Grossstadtlegende/Hallbach_cylinder/CAD/HalbachCylinderRemakeV3.9 (9.95 magnet length, 15mm thick) w groove.STL

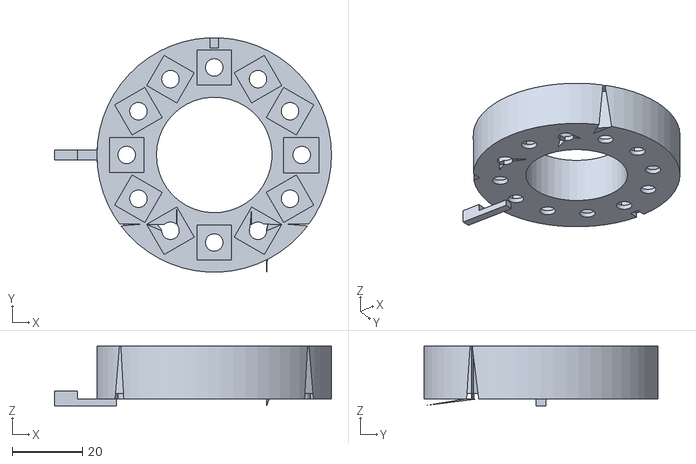
[picture p2: CAD file, 2020-01-30]
CAD/HalbachCylinderRemakeV3.9 (9.95 magnet length, 15mm thick) w groove.STL
79.1 x 67.0 x 17.0
