Grossstadtlegende/Hallbach_cylinder/CAD/Back cover.STL

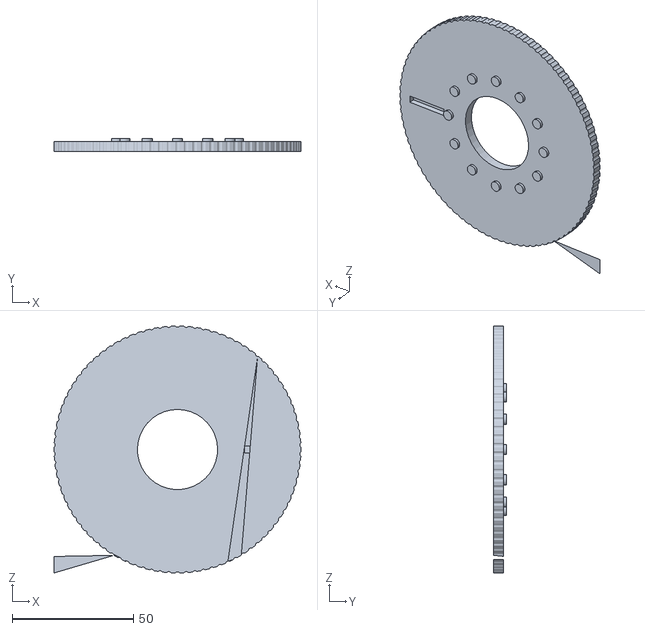
[picture p3: CAD file, 2020-01-30]
CAD/Back cover.STL
101.7 x 5.15 x 101.7
