Grossstadtlegende/Hallbach_cylinder/CAD/Outer ring w groove v2.STL

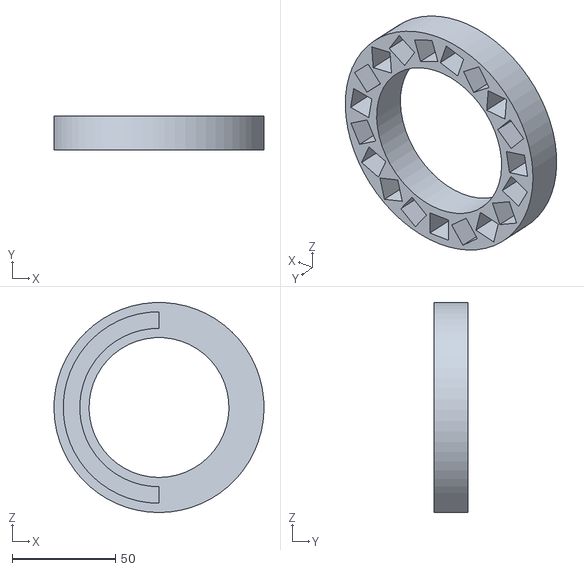
[picture p4: CAD file, 2020-01-30]
CAD/Outer ring w groove v2.STL
101.7 x 16.5 x 101.8
