Grossstadtlegende/Hallbach_cylinder/CAD/axial hall probe holder 32.25.SLDPRT

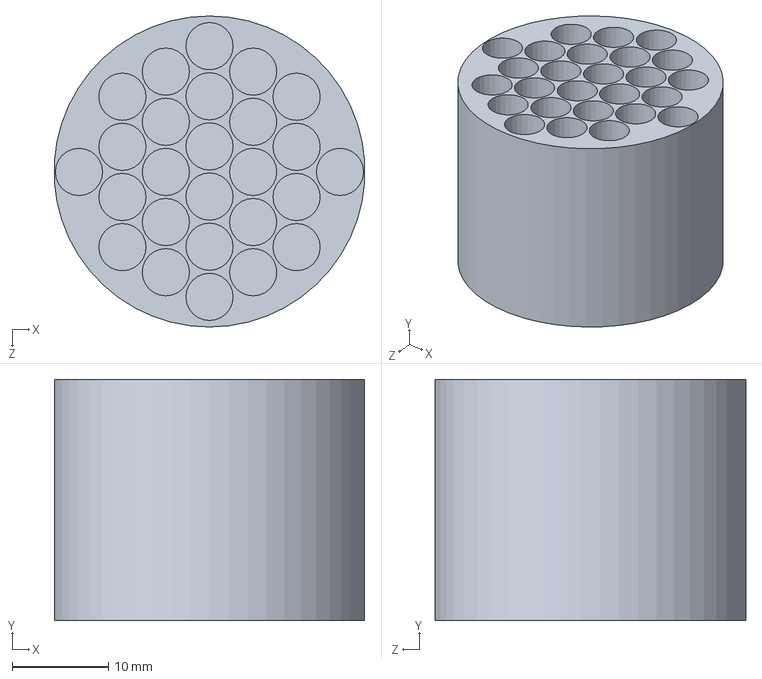
[picture p5: CAD file, 2019-03-29]
CAD/axial hall probe holder 32.25.SLDPRT
32.2 x 25.0 x 32.2 mm
