Grossstadtlegende/Hallbach_cylinder/CAD/HalbachCylinderRemakeV3.9 (9.95 magnet length, 15mm thick).STL

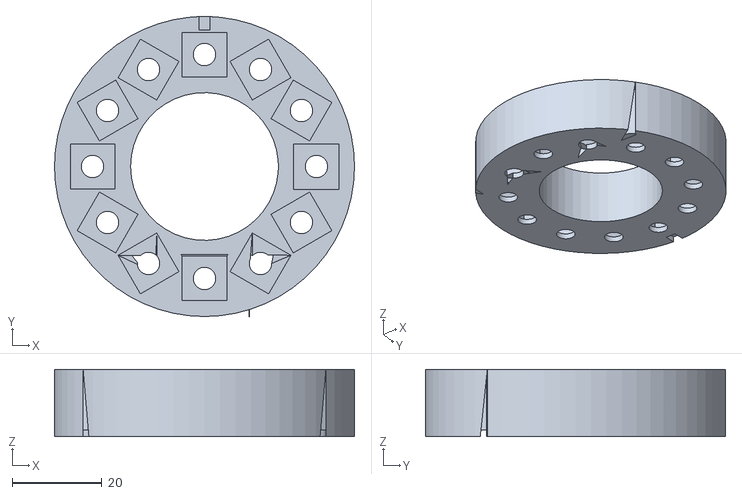
[picture p6: CAD file, 2019-03-29]
CAD/HalbachCylinderRemakeV3.9 (9.95 magnet length, 15mm thick).STL
67.0 x 67.0 x 15.0
