Grossstadtlegende/Hallbach_cylinder/CAD/V3.95 top half.STL

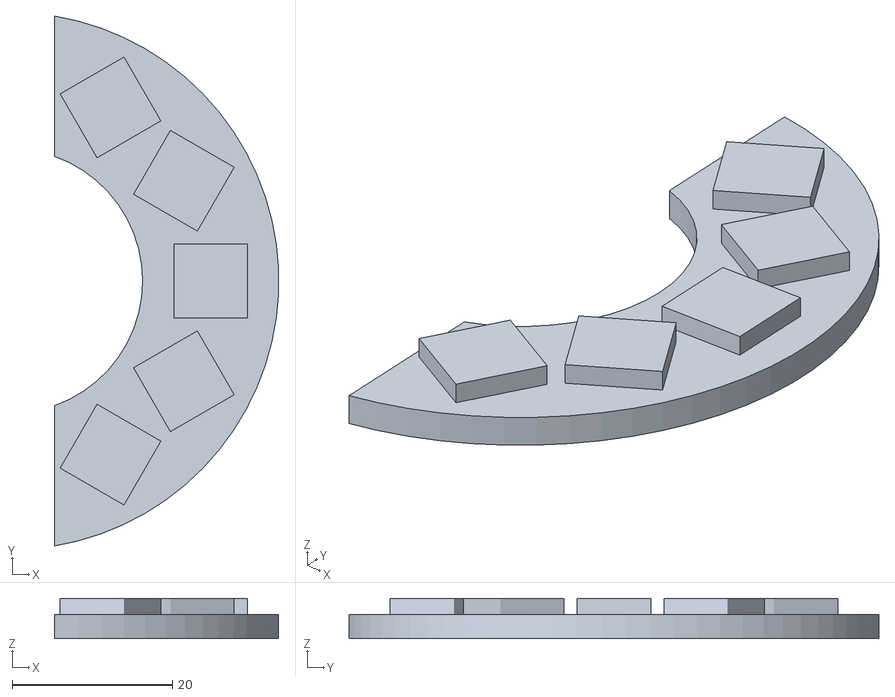
[picture p7: CAD file, 2019-03-29]
CAD/V3.95 top half.STL
28.0 x 66.1 x 5.00
