Grossstadtlegende/Hallbach_cylinder/CAD/V3.95 top half 2.STL

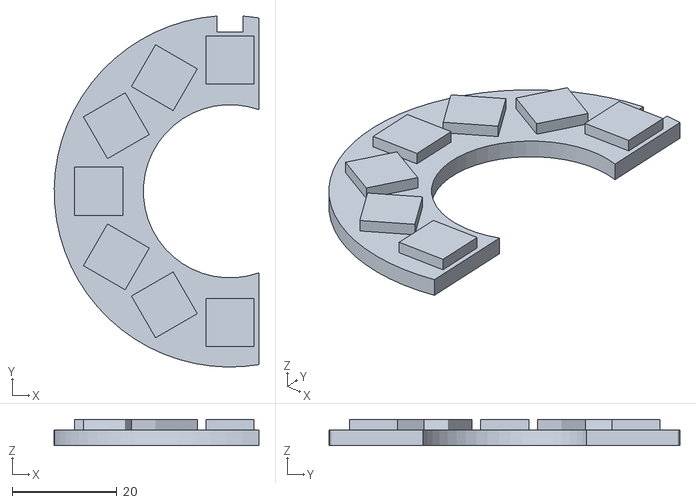
[picture p8: CAD file, 2019-03-29]
CAD/V3.95 top half 2.STL
39.0 x 66.9 x 5.00
