Grossstadtlegende/Hallbach_cylinder/CAD/HalbachTest0.STL

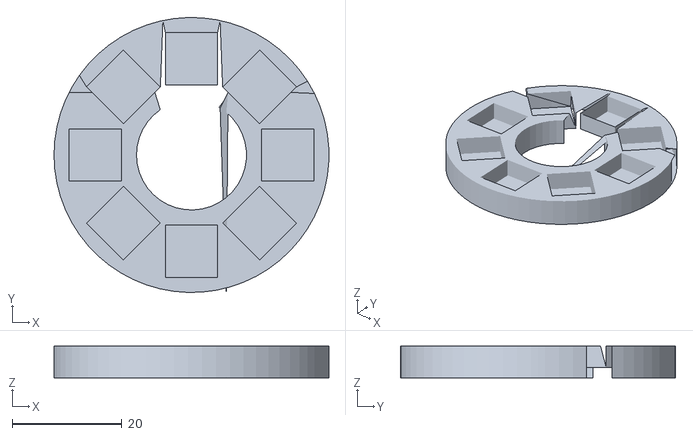
[picture p9: CAD file, 2019-02-19]
CAD/HalbachTest0.STL
50.0 x 50.0 x 5.76
