Grossstadtlegende/Hallbach_cylinder/CAD/Magnet.SLDPRT

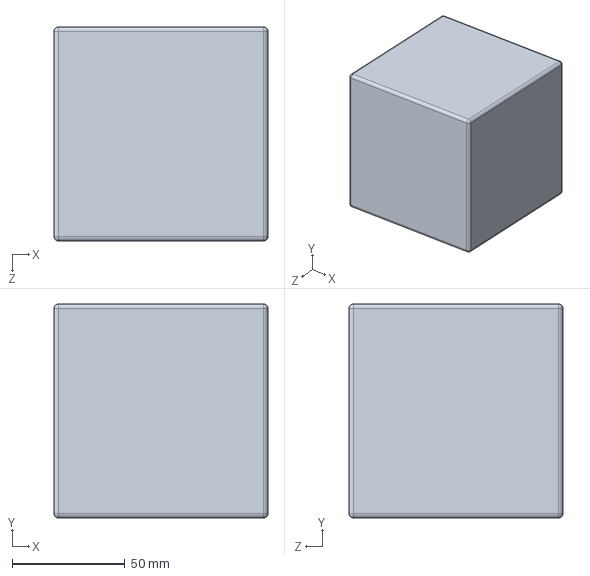
[picture p10: CAD file, 2019-01-28]
CAD/Magnet.SLDPRT
95.0 x 95.0 x 95.0 mm
