Grossstadtlegende/Hallbach_cylinder/(list of files, cad)

Other CAD files:
CAD/HalbachCylinder_V0.sldprt
