Grossstadtlegende/Hallbach_cylinder/Data/Individual Magnet testing.xlsx

Magnet 1 | (mT) |  |  | Average | Magnet 2
face 1 | 123.9 | 125.6 | 130.6 | 126.70 | 130.2 | 134.6 | 132.6 | 132.47
face 2 | -134.8 | -127.7 | -132.8 | -131.77 | -129.2 | -131.2 | -132.8 | -131.07
face 3 | 23.84 |  |  | 7.95 | Magnet 3
face 4 | -20.41 |  |  | -6.80 | 128 | 133.4 | 132.4 | 131.27
face 5 | -30.4 |  |  | -10.13 | -122.8 | -128.8 | -131.1 | -127.57
face 6 | -20.05 |  |  | -6.68 | Magnet 4
 |  |  |  | 0.00
where face 1 and 2 are along magnetic axis, and 4-6 should be comparatively weak |  |  |  | 0.00
Notes: |  |  |  | 0.00 | Magnet 5
*Began by zeroing transverse probe in the zero-field thingy |  |  |  | 0.00
Does appear to be slight differences in size, as fit of magnets varied in printed plate |  |  |  | 0.00
For clarification, measurements were taken with the unmarked side against the face |  |  |  | 0.00
White dots are considered as face 1 |  |  |  | 0.00
Tested magnets are in their own row in box |  |  |  | 0.00
 |  |  |  | 0.00
