Grossstadtlegende/Hallbach_cylinder/(commit log)

2019-01-25 added mikes original CAD
    [HalbachCylinder_V0.sldprt]
2019-01-25 Create Raich, Blümler - 2004 - Design and construction of a dipolar Halbach array with a homogeneous field from identical bar magnets NMR Mand.pdf
2019-01-28 Create Magnet.SLDPRT
    Created a CAD drawing for a cubic magnet
    [Magnet.SLDPRT]
2019-02-05 Equation Spreadsheet
    A spreadsheet containing both the equations given in Raich and Blumler as well as for calculating tangental and radial components of a magnetic field. Errors extremely plausible, but is being revised.
    [Magnet equations.xlsx]
2019-02-18 Halbach magnet positions
    A far simpler and more accurate spreadsheet with equations for the magnet positions
    [HalbachPositions (version 1).xlsx]
2019-02-19 HalbachTest0
    A .stl file for the first printed version of the Halbach cylinder
    [HalbachPositions (version 1).xlsx, HalbachTest0.STL]
2019-02-22 Updated AND color-coded for fun
    [HalbachPositions (version 1).xlsx, HalbachTest0.STL, Magnet equations.xlsx]
2019-03-04 Update HalbachPositions (version 1).xlsx
    [HalbachPositions (version 1).xlsx]
2019-03-29 Final (or near so) designs for the Hallbach cylinder
    [HalbachCylinderRemakeV3.9 (9.95 magnet length, 15mm thick).STL, HalbachPositions (version 1).xlsx, V3.95 top half 2.STL, V3.95 top half.STL, axial hall probe holder 32.25.SLDPRT]
2019-04-26 General updates of files
    [Back cover.STL, Halbach positions for outer ring.xlsx, HalbachCylinderRemakeV3.9 (9.95 magnet length, 15mm thick) w groove.STL, HalbachPositions (version 1).xlsx, Magnet equations.xlsx, Outer ring w groove v2.STL]
2019-07-05 Create Raich, Blümler - 2004 - Design and construction of a dipolar Halbach array with a homogeneous field from identical bar magnets NMR Mand.pdf
    add pdf
2020-01-28 Add new notes
    Added a document with a general overview of prototypes and project goals
2020-02-05 Organizational changes
    [Axial hall data (Stephanie).xlsx, Transverse probe data- 1st orientation.xlsx]
2020-02-08 edits and added data
    [Transverse probe data (orientation #2).xlsx]
2020-02-11 Diagram of field around magnet
2020-02-20 Create Individual Magnet testing.xlsx
    [Individual Magnet testing.xlsx]
